buk7456/Arduino-LoRa-RC-transmitter-and-reciever/etc/schematics/Transmitter_ks0108_version.pdf

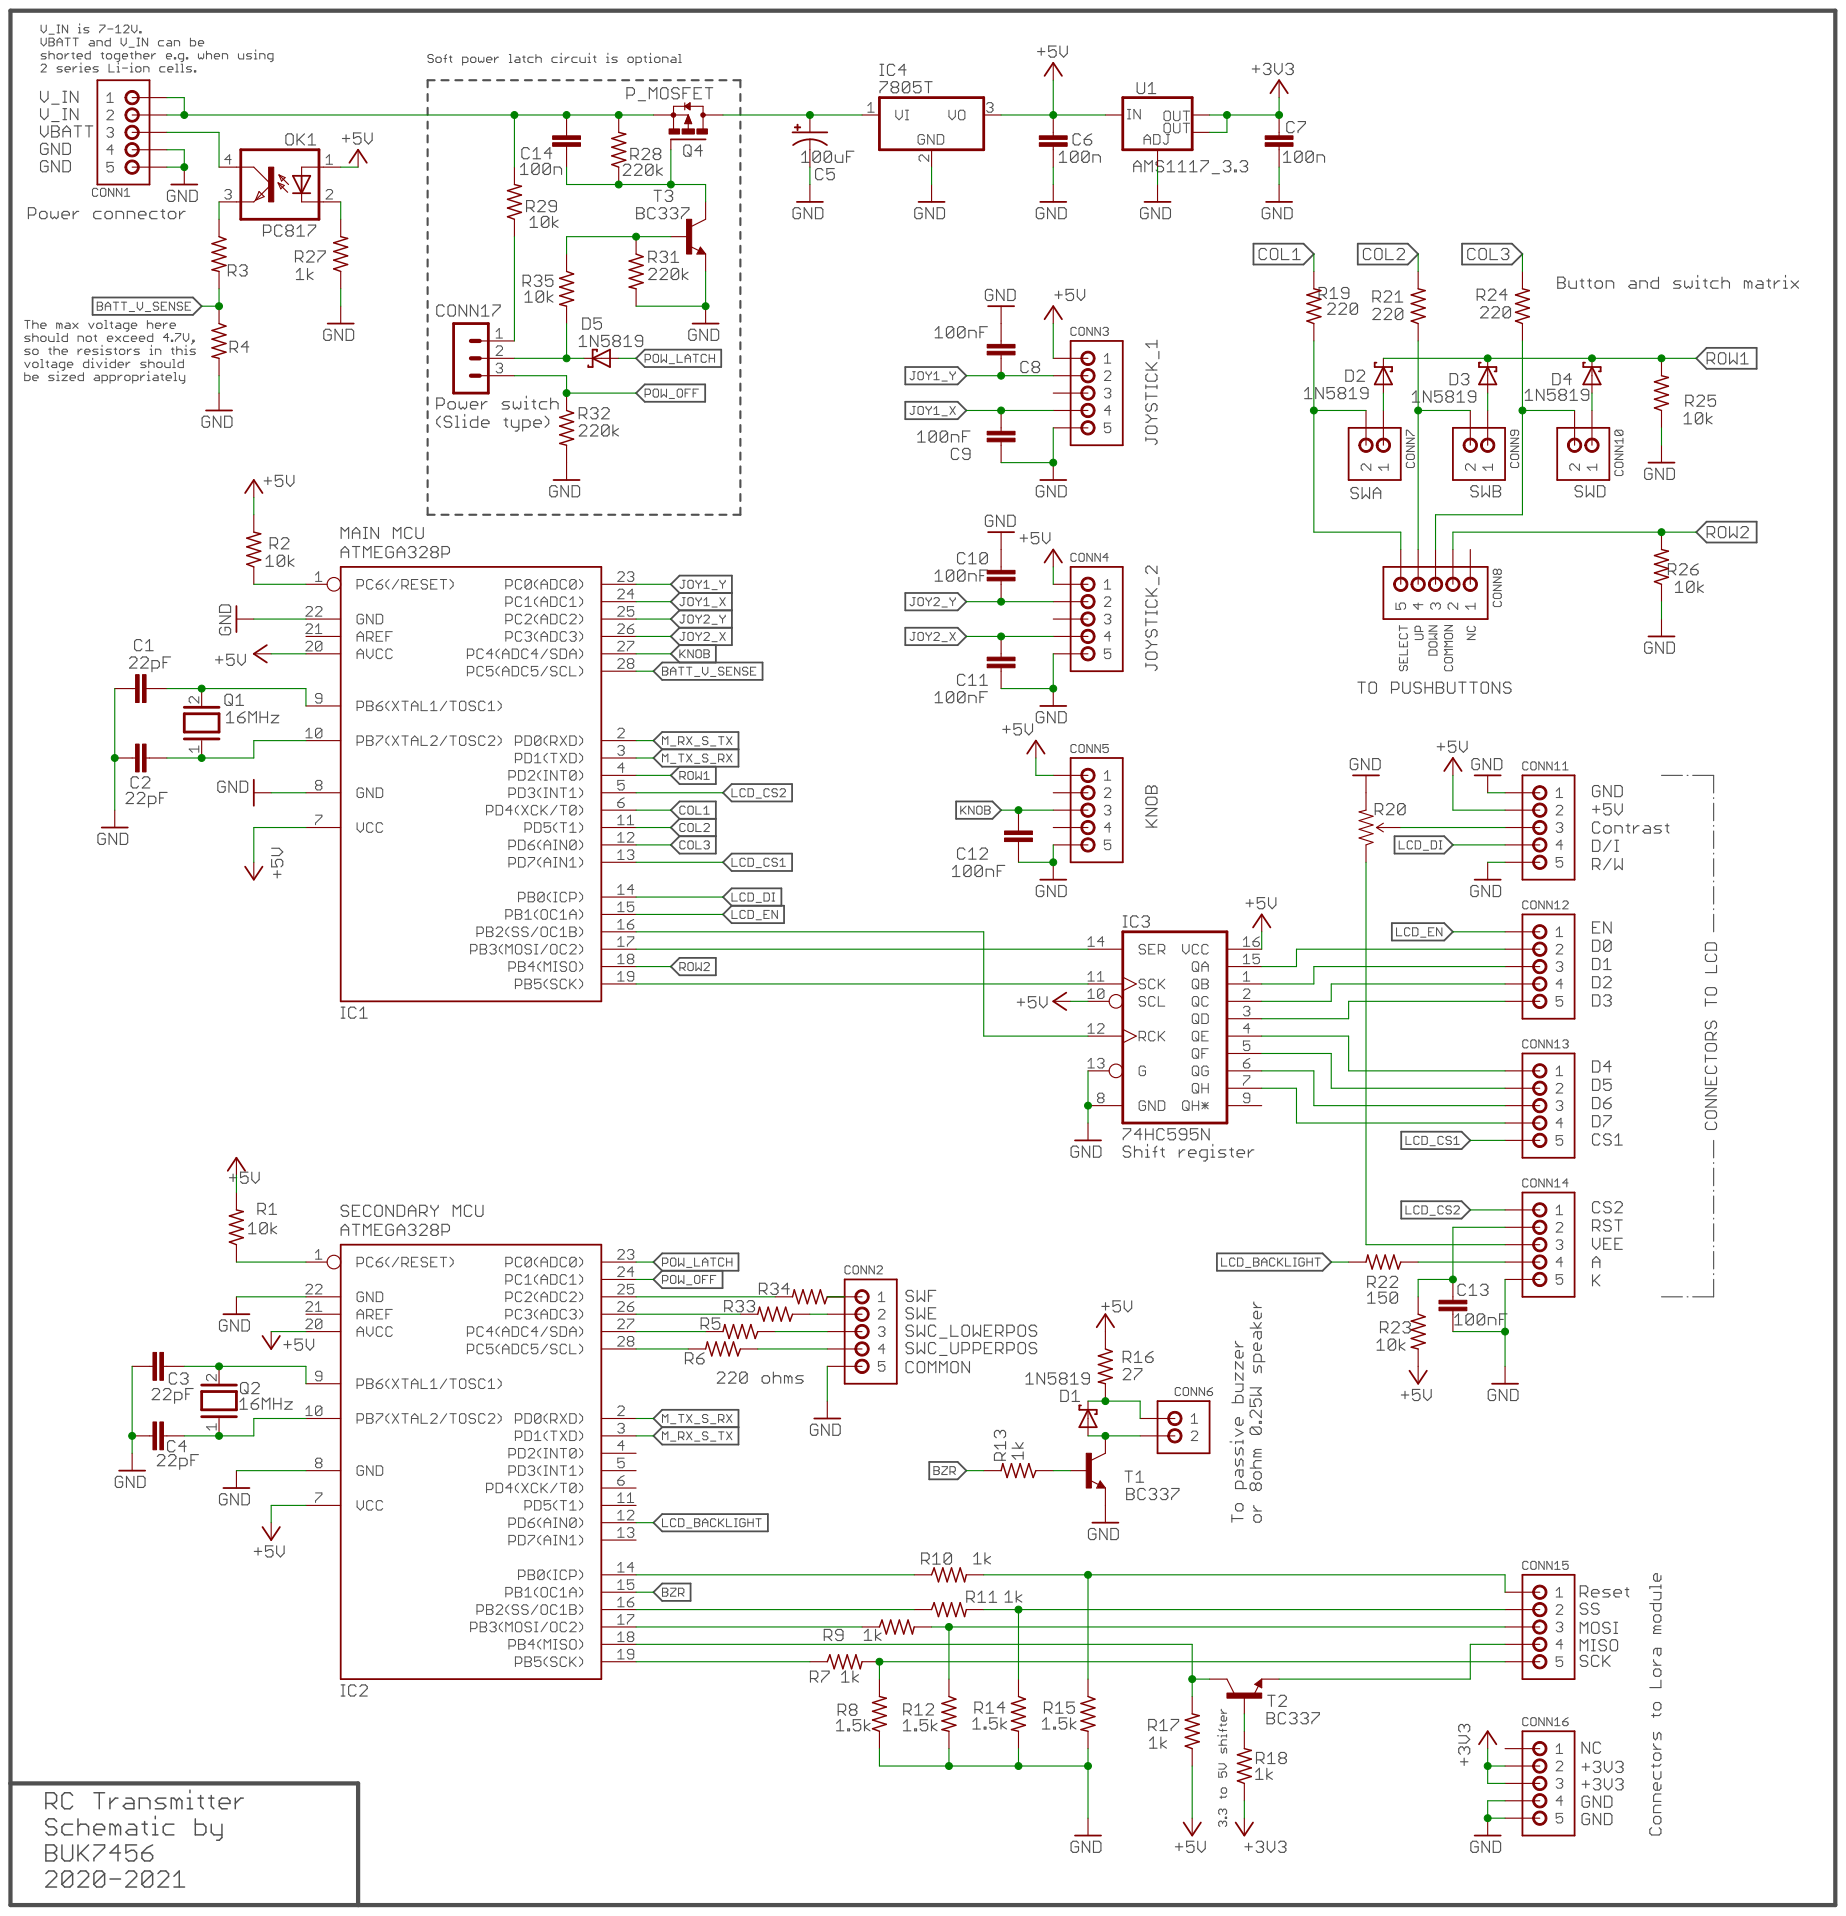
[picture p3: page 1]
