buk7456/Arduino-LoRa-RC-transmitter-and-reciever/etc/schematics/receiver.pdf

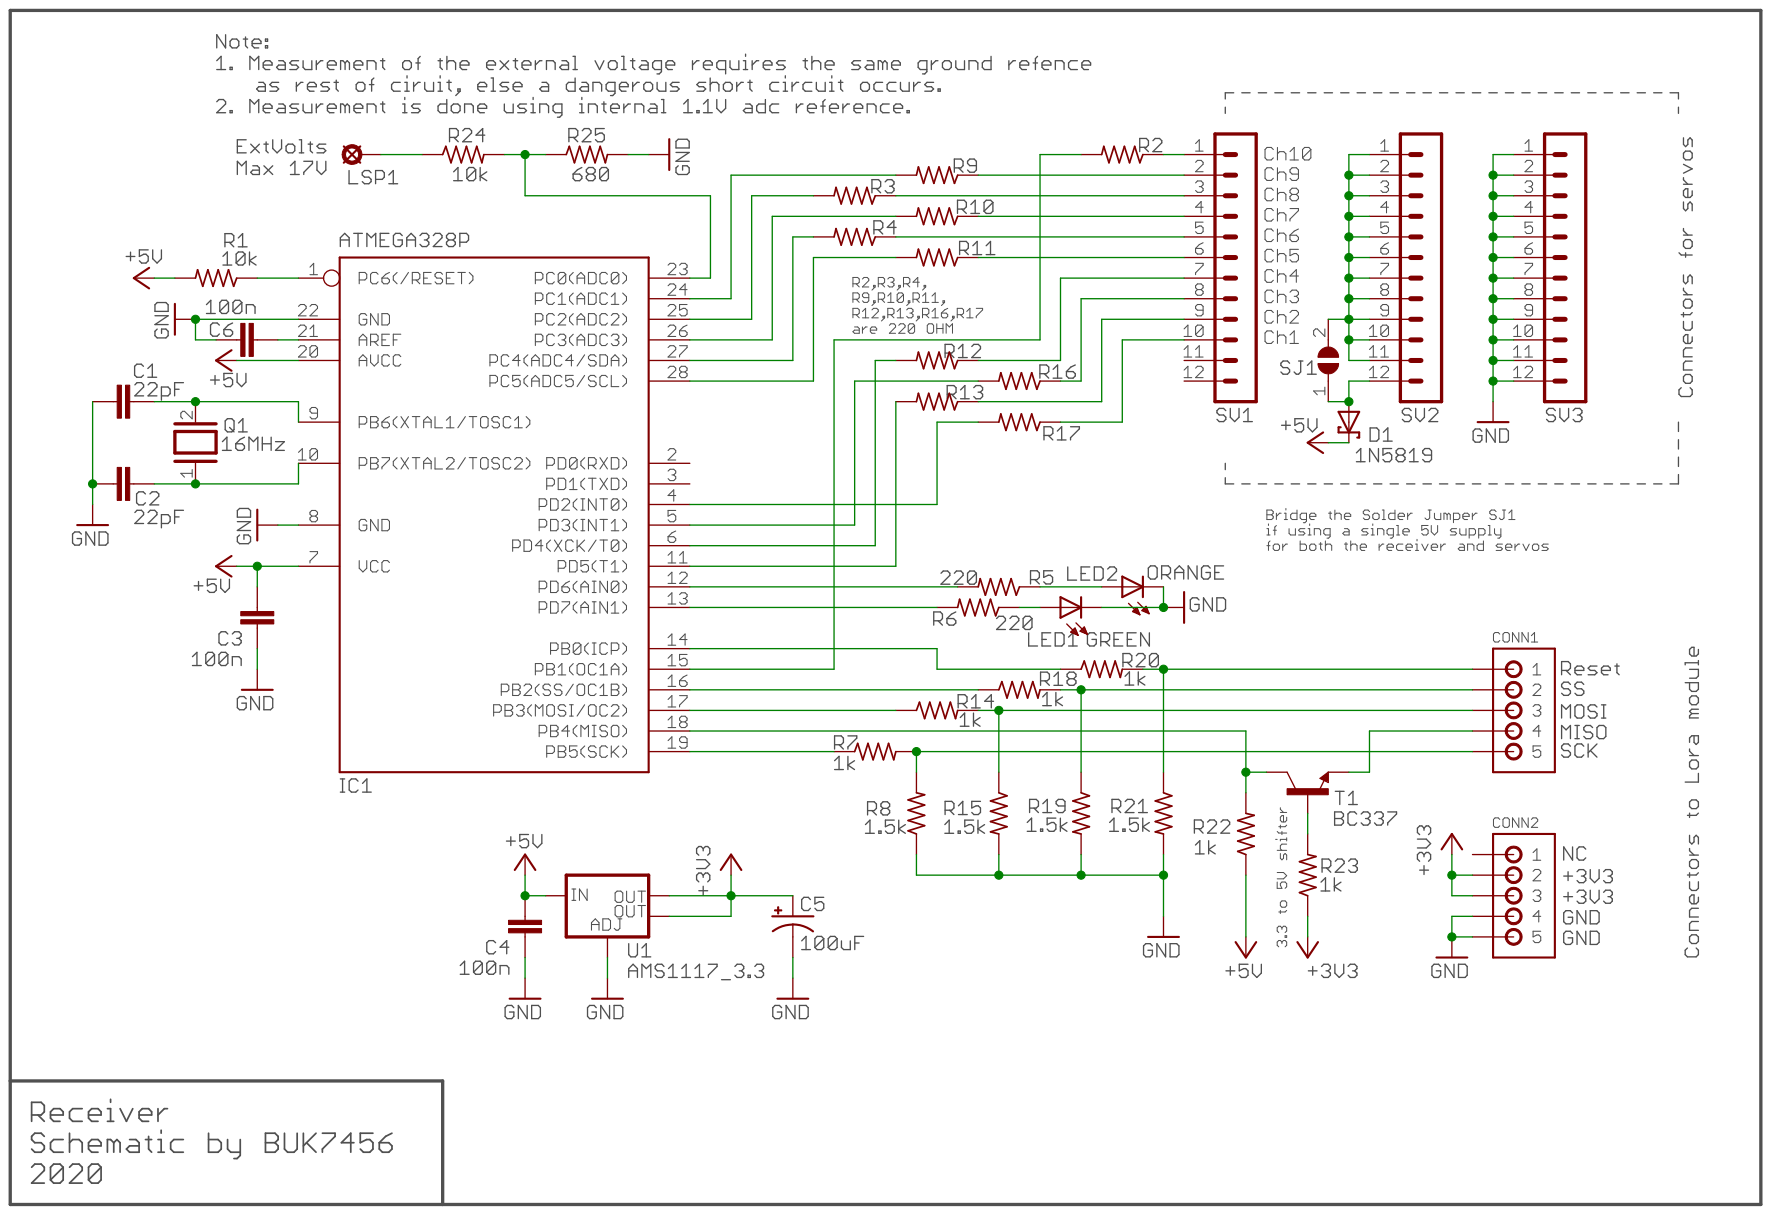
[picture p4: page 1]
