buk7456/Arduino-LoRa-RC-transmitter-and-reciever/(list of files, drawings)

Other design files:
etc/simu/UI128x64simu.pdsprj
