buk7456/Arduino-LoRa-RC-transmitter-and-reciever/etc/schematics/Transmitter_ks0108_version.sch

## EAGLE design etc/schematics/Transmitter_ks0108_version.sch (2021-07-11)

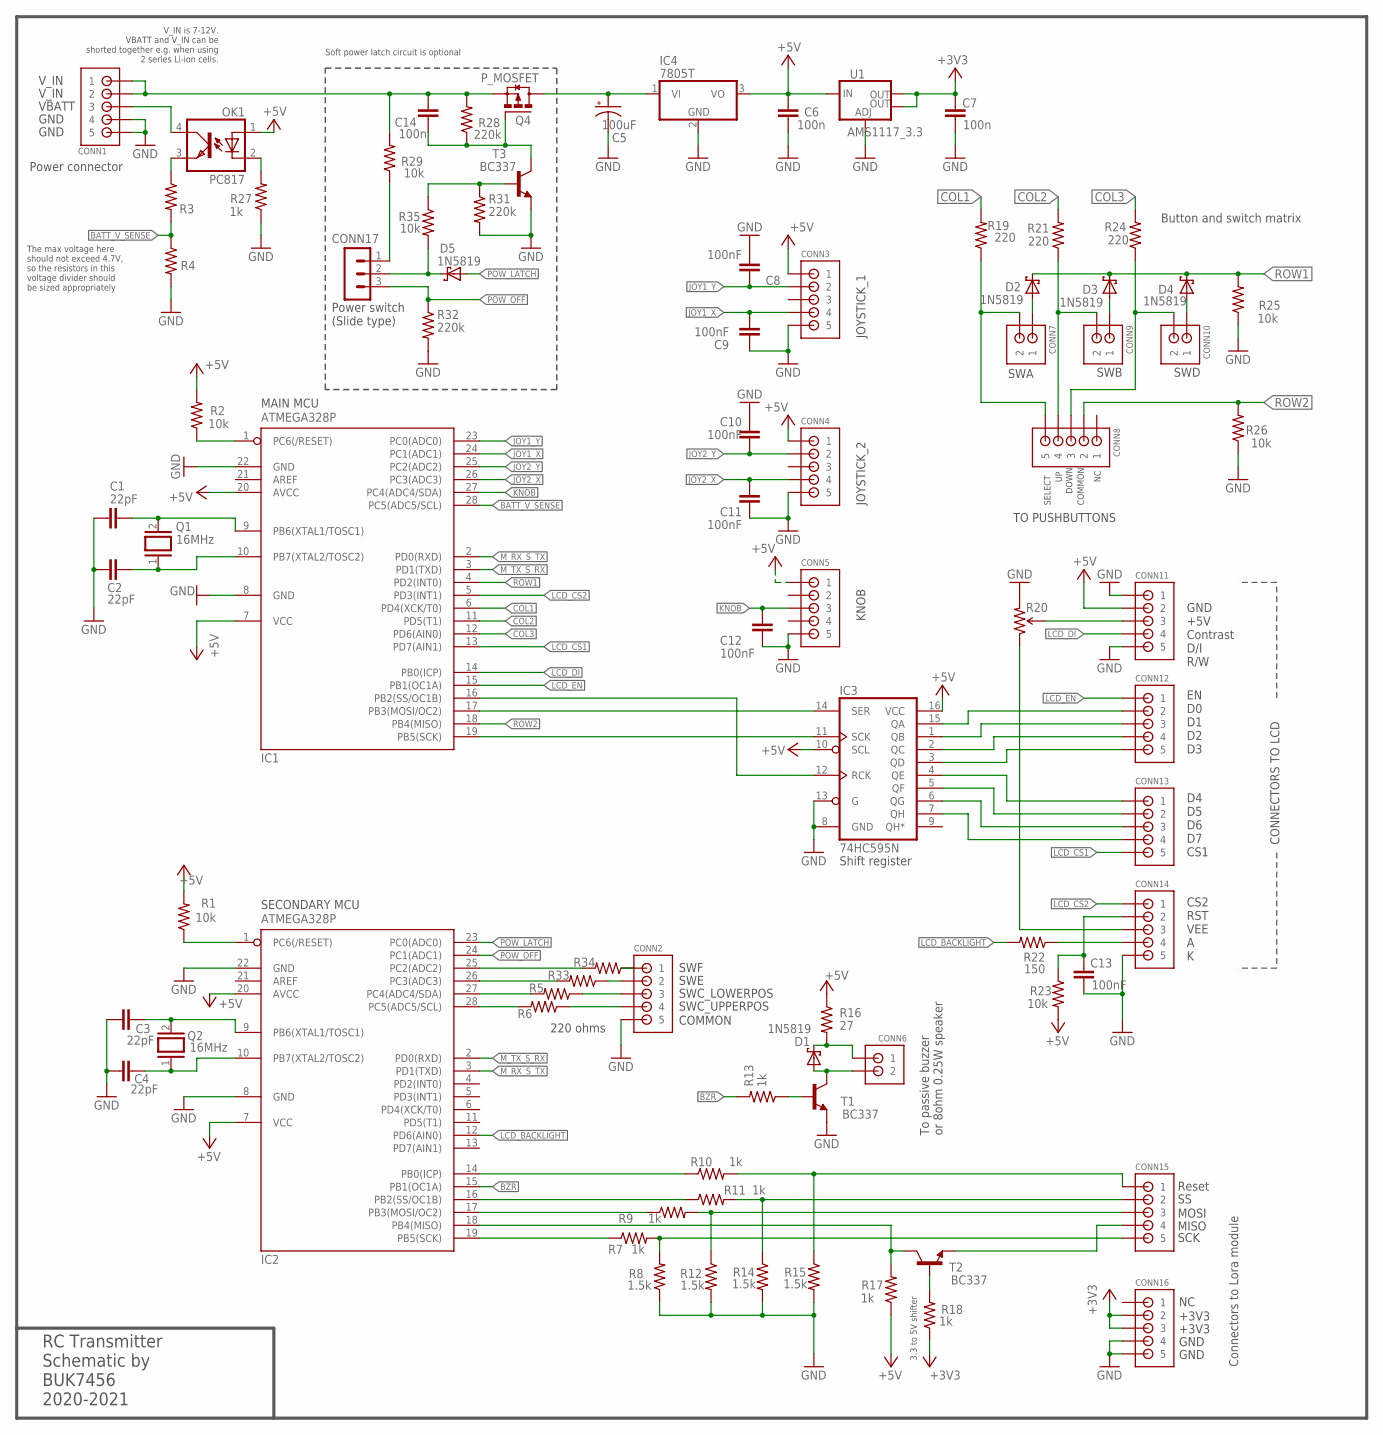
[picture p5: schematic Transmitter_ks0108_version.sch]

Parts:
C1, C2, C3, C4: 22pF; C025-025X050
C5: 100uF; E2,5-6E
C6, C7, C14: 100n; C025-025X050
C8, C9, C10, C11, C12, C13: 100nF; C025-025X050
CONN1: POW; JST_B5B-PH_HEADER
CONN2: RADIO; JST_B5B-PH_HEADER
CONN3, CONN4, CONN5, CONN8, CONN15, CONN16: JST-PH_5-PIN_HEADER; JST_B5B-PH_HEADER
CONN6, CONN7, CONN9, CONN10: JST-PH_2-PIN_HEADER; JST_B2B-PH_HEADER
CONN11, CONN12, CONN13, CONN14: AUX; JST_B5B-PH_HEADER
CONN17: MA03-1
D1, D2, D3, D4, D5: 1N5819; DO41-7.6
IC1, IC2: ATMEGA328P; DIL28-3
IC3: 74HC595N; DIL16
IC4: 7805T; TO220H
OK1: PC817; DIL04
Q1, Q2: 16MHz; QS
Q4: P_MOSFET; SUPER-SOT3
R1, R23: 10k; 0204/5
R2: 10k; 0207/10
R3: 1k; 0207/10
R4, R27: 1k; 0204V
R5, R6, R19, R24, R33, R34: 220; 0204/7
R7, R9, R10, R11, R13, R18: 1k; 0204/5
R8, R12, R14, R15: 1.5k; 0204V
R16: 27; 0204/7
R17: 1k; 0204/7
R20: TRIMPOTPTH; TRIM_POT_PTH
R21: 220; 0207/10
R22: 150; 0204V
R25, R26: 10k; 0204V
R28, R31, R32: 220k; 0204/7
R29, R35: 10k; 0204/7
T1, T2, T3: BC337; TO92
U1: AMS1117_3.3; SOT223

Connections:
+3V3: C7.2, CONN16.P2 (2), CONN16.P3 (3), R18.1, U1.2 (OUT), U1.4 (OUT)
+5V: C6.2, CONN3.P1 (1), CONN4.P1 (1), CONN5.P1 (1), CONN11.P2 (2), IC1.7 (VCC), IC1.20 (AVCC), IC2.7 (VCC), IC2.20 (AVCC), IC3.10 (SCL), IC3.16 (VCC), IC4.3 (VO), OK1.1 (A), R1.2, R2.2, R16.1, R17.1, R23.2, U1.3 (IN)
BATT_V_SENSE: IC1.28 (PC5(ADC5/SCL)), R3.2, R4.1
BZR: IC2.15 (PB1(OC1A)), R13.2
COL1: IC1.6 (PD4(XCK/T0)), R19.2
COL2: IC1.11 (PD5(T1)), R21.2
COL3: IC1.12 (PD6(AIN0)), R24.2
GND: C1.1, C2.1, C3.1, C4.1, C5.-, C6.1, C7.1, C8.2, C9.1, C10.2, C11.1, C12.1, C13.2, CONN1.P4 (4), CONN1.P5 (5), CONN2.P5 (5), CONN3.P5 (5), CONN4.P5 (5), CONN5.P5 (5), CONN11.P1 (1), CONN11.P5 (5), CONN14.P5 (5), CONN16.P4 (4), CONN16.P5 (5), IC1.8 (GND), IC1.22 (GND), IC2.8 (GND), IC2.22 (GND), IC3.8 (GND), IC3.13 (G), IC4.2 (GND), R4.2, R8.1, R12.2, R14.2, R15.2, R20.3 (CW), R25.1, R26.1, R27.1, R31.2, R32.2, T1.1 (E), T3.1 (E), U1.1 (ADJ)
JOY1_X: C9.2, CONN3.P4 (4), IC1.24 (PC1(ADC1))
JOY1_Y: C8.1, CONN3.P2 (2), IC1.23 (PC0(ADC0))
JOY2_X: C11.2, CONN4.P4 (4), IC1.26 (PC3(ADC3))
JOY2_Y: C10.1, CONN4.P2 (2), IC1.25 (PC2(ADC2))
KNOB: C12.2, CONN5.P3 (3), IC1.27 (PC4(ADC4/SDA))
LCD_BACKLIGHT: IC2.12 (PD6(AIN0)), R22.2
LCD_CS1: CONN13.P5 (5), IC1.13 (PD7(AIN1))
LCD_CS2: CONN14.P1 (1), IC1.5 (PD3(INT1))
LCD_DI: CONN11.P4 (4), IC1.14 (PB0(ICP))
LCD_EN: CONN12.P1 (1), IC1.15 (PB1(OC1A))
LCD_RST1: C13.1, CONN14.P2 (2), R23.1
MASTER_RST: IC1.1 (PC6(/RESET)), R2.1
MASTER_RST1: IC2.1 (PC6(/RESET)), R1.1
MISO: IC2.18 (PB4(MISO)), R17.2, T2.3 (C)
M_RX_S_TX: IC1.2 (PD0(RXD)), IC2.3 (PD1(TXD))
M_TX_S_RX: IC1.3 (PD1(TXD)), IC2.2 (PD0(RXD))
unnamed: CONN1.P3 (3), OK1.4 (COL)
unnamed: CONN12.P2 (2), IC3.15 (QA)
unnamed: CONN12.P3 (3), IC3.1 (QB)
unnamed: CONN12.P4 (4), IC3.2 (QC)
unnamed: CONN12.P5 (5), IC3.3 (QD)
unnamed: CONN13.P1 (1), IC3.4 (QE)
unnamed: CONN13.P2 (2), IC3.5 (QF)
unnamed: CONN13.P3 (3), IC3.6 (QG)
unnamed: C1.2, IC1.9 (PB6(XTAL1/TOSC1)), Q1.2
unnamed: C2.2, IC1.10 (PB7(XTAL2/TOSC2)), Q1.1
unnamed: IC1.19 (PB5(SCK)), IC3.11 (SCK)
unnamed: CONN14.P4 (4), R22.1
unnamed: IC1.17 (PB3(MOSI/OC2)), IC3.14 (SER)
unnamed: IC1.16 (PB2(SS/OC1B)), IC3.12 (RCK)
unnamed: IC2.28 (PC5(ADC5/SCL)), R6.2
unnamed: C3.2, IC2.9 (PB6(XTAL1/TOSC1)), Q2.2
unnamed: C4.2, IC2.10 (PB7(XTAL2/TOSC2)), Q2.1
unnamed: CONN7.P2 (2), CONN8.P5 (5), R19.1
unnamed: CONN8.P4 (4), CONN9.P2 (2), R21.1
unnamed: CONN8.P3 (3), CONN10.P2 (2), R24.1
unnamed: CONN7.P1 (1), D2.A
unnamed: CONN9.P1 (1), D3.A
unnamed: CONN10.P1 (1), D4.A
unnamed: IC2.14 (PB0(ICP)), R10.1
unnamed: CONN13.P4 (4), IC3.7 (QH)
unnamed: IC2.27 (PC4(ADC4/SDA)), R5.2
unnamed: CONN2.P3 (3), R5.1
unnamed: CONN15.P4 (4), T2.1 (E)
unnamed: CONN2.P4 (4), R6.1
unnamed: IC2.16 (PB2(SS/OC1B)), R11.1
unnamed: R13.1, T1.2 (B)
unnamed: CONN6.P2 (2), D1.A, T1.3 (C)
unnamed: CONN6.P1 (1), D1.C, R16.2
unnamed: CONN15.P2 (2), R11.2, R14.1
unnamed: IC2.17 (PB3(MOSI/OC2)), R9.1
unnamed: R18.2, T2.2 (B)
unnamed: CONN15.P1 (1), R10.2, R15.1
unnamed: OK1.3 (EMIT), R3.1
unnamed: C14.2, CONN1.P1 (1), CONN1.P2 (2), Q4.2 (S), R28.2, R29.2
unnamed: CONN15.P3 (3), R9.2, R12.1
unnamed: IC2.19 (PB5(SCK)), R7.1
unnamed: CONN15.P5 (5), R7.2, R8.2
unnamed: C14.1, Q4.1 (G), R28.1, T3.3 (C)
unnamed: OK1.2 (C), R27.2
unnamed: CONN17.1, R29.1
unnamed: CONN11.P3 (3), R20.2 (WIPER)
unnamed: C5.+, IC4.1 (VI), Q4.3 (D)
unnamed: CONN14.P3 (3), R20.1 (CCW)
unnamed: CONN2.P2 (2), R33.1
unnamed: CONN2.P1 (1), R34.1
unnamed: IC2.26 (PC3(ADC3)), R33.2
unnamed: IC2.25 (PC2(ADC2)), R34.2
unnamed: R31.1, R35.1, T3.2 (B)
unnamed: CONN17.2, D5.C, R35.2
POW_LATCH: D5.A, IC2.23 (PC0(ADC0))
POW_OFF: CONN17.3, IC2.24 (PC1(ADC1)), R32.1
ROW1: D2.C, D3.C, D4.C, IC1.4 (PD2(INT0)), R25.2
ROW2: CONN8.P2 (2), IC1.18 (PB4(MISO)), R26.2

Notes on the sheet:
3.3 to 5V shifter
SELECT
DOWN
COMMON
GND +5V Contrast D/I R/W
EN D0 D1 D2 D3
D4 D5 D6 D7 CS1
CS2 RST VEE A K
Shift register
MAIN MCU
SECONDARY MCU
CONNECTORS TO LCD
GND
VBATT
Power connector
The max voltage here should not exceed 4.7V, so the resistors in this voltage divider should be sized appropriately
JOYSTICK_1
JOYSTICK_2
KNOB
SWA
SWB
SWD
TO PUSHBUTTONS
To passive buzzer or 8ohm 0.25W speaker
Button and switch matrix
Connectors to Lora module
Reset
MOSI
MISO
SCK
+3V3
RC Transmitter Schematic by BUK7456 2020-2021
Power switch (Slide type)
220 ohms
SWE
SWF
SWC_LOWERPOS
SWC_UPPERPOS
Soft power latch circuit is optional
V_IN
V_IN is 7-12V. VBATT and V_IN can be shorted together e.g. when using 2 series Li-ion cells.
