buk7456/Arduino-LoRa-RC-transmitter-and-reciever/etc/schematics/receiver.sch

## EAGLE design etc/schematics/receiver.sch (2021-03-05)

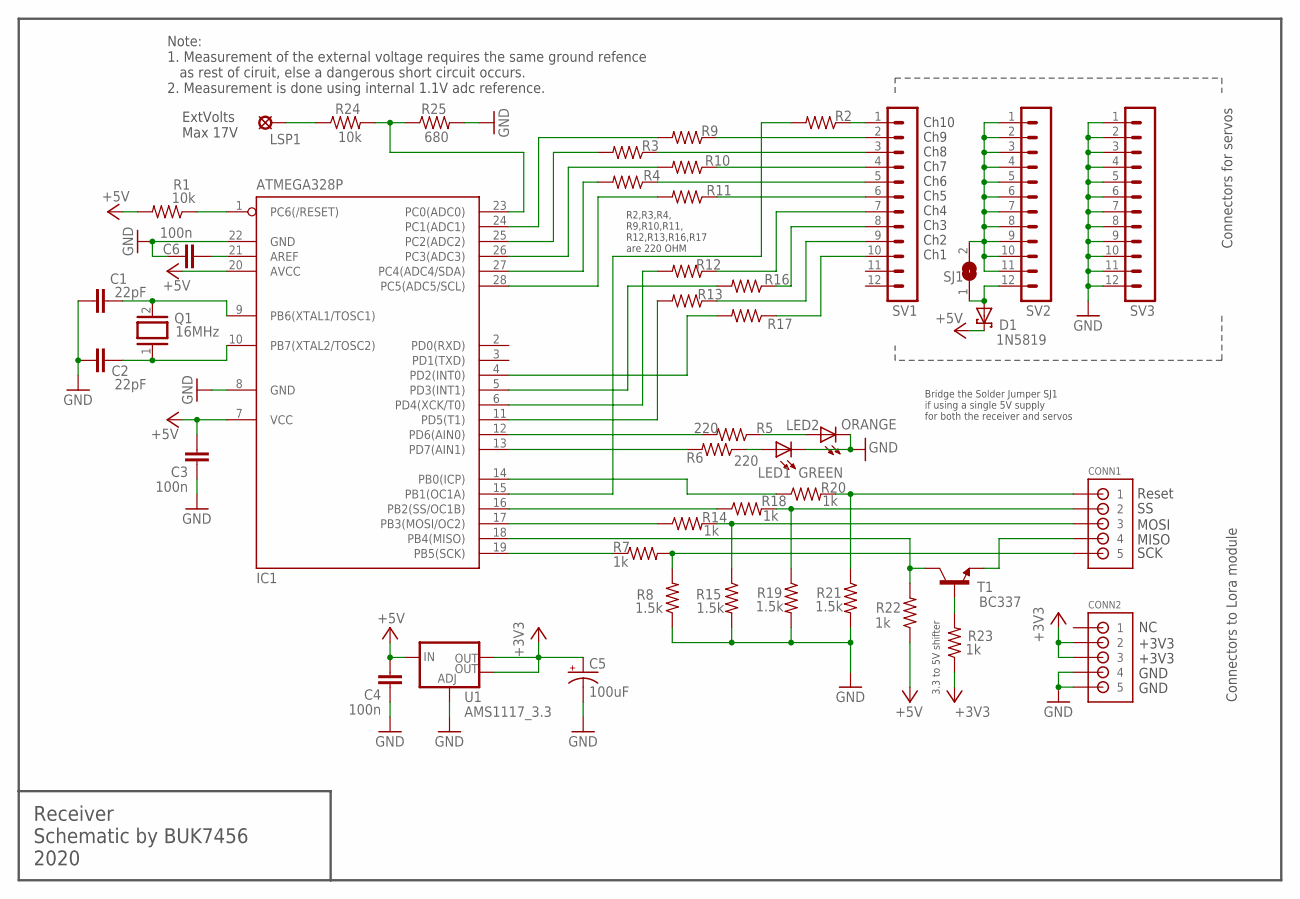
[picture p6: schematic receiver.sch]

Parts:
C1, C2: 22pF; C025-025X050
C3, C4, C6: 100n; C025-025X050
C5: 100uF; E2,5-6E
CONN1, CONN2: JST-PH_5-PIN_HEADER; JST_B5B-PH_HEADER
D1: 1N5819; DO41-7.6
IC1: ATMEGA328P; DIL28-3
LED1: GREEN; LED3MM
LED2: ORANGE; LED3MM
LSP1: LSP10
Q1: 16MHz; QS
R1, R24: 10k; 0204/5
R2, R3, R4, R9, R10, R11, R12, R13, R16, R17: 220; 0204V
R5, R6: 220; 0204/5
R7, R14, R18, R20, R23: 1k; 0204/5
R8, R15, R19, R21: 1.5k; 0204V
R22: 1k; 0204/7
R25: 680; 0204/5
SJ1: SJ
SV1, SV2, SV3: MA12-1
T1: BC337; TO92
U1: AMS1117_3.3; SOT223

Connections:
+3V3: C5.+, CONN2.P2 (2), CONN2.P3 (3), R23.1, U1.2 (OUT), U1.4 (OUT)
+5V: C3.2, C4.2, D1.C, IC1.7 (VCC), IC1.20 (AVCC), R1.2, R22.1, U1.3 (IN)
EXT_V_MAX_17V: LSP1.MP, R24.1
GND: C1.1, C2.1, C3.1, C4.1, C5.-, C6.2, CONN2.P4 (4), CONN2.P5 (5), IC1.8 (GND), IC1.22 (GND), LED1.K (C), LED2.K (C), R8.1, R15.2, R19.2, R21.2, R25.2, SV3.1, SV3.2, SV3.3, SV3.4, SV3.5, SV3.6, SV3.7, SV3.8, SV3.9, SV3.10, SV3.11, SV3.12, U1.1 (ADJ)
MISO: IC1.18 (PB4(MISO)), R22.2, T1.3 (C)
unnamed: IC1.15 (PB1(OC1A)), R2.2
unnamed: IC1.24 (PC1(ADC1)), R9.2
unnamed: IC1.25 (PC2(ADC2)), R3.2
unnamed: IC1.26 (PC3(ADC3)), R10.2
unnamed: IC1.27 (PC4(ADC4/SDA)), R4.2
unnamed: IC1.28 (PC5(ADC5/SCL)), R11.2
unnamed: R2.1, SV1.1
unnamed: R3.1, SV1.3
unnamed: R9.1, SV1.2
unnamed: R10.1, SV1.4
unnamed: R4.1, SV1.5
unnamed: R11.1, SV1.6
unnamed: IC1.4 (PD2(INT0)), R17.2
unnamed: IC1.5 (PD3(INT1)), R16.2
unnamed: R12.1, SV1.7
unnamed: C1.2, IC1.9 (PB6(XTAL1/TOSC1)), Q1.2
unnamed: C2.2, IC1.10 (PB7(XTAL2/TOSC2)), Q1.1
unnamed: R16.1, SV1.8
unnamed: R17.1, SV1.10
unnamed: IC1.6 (PD4(XCK/T0)), R12.2
unnamed: SJ1.2, SV2.1, SV2.2, SV2.3, SV2.4, SV2.5, SV2.6, SV2.7, SV2.8, SV2.9, SV2.10, SV2.11
unnamed: LED2.A, R5.1
unnamed: IC1.11 (PD5(T1)), R13.2
unnamed: IC1.16 (PB2(SS/OC1B)), R18.1
unnamed: R13.1, SV1.9
unnamed: LED1.A, R6.1
unnamed: IC1.12 (PD6(AIN0)), R5.2
unnamed: CONN1.P4 (4), T1.1 (E)
unnamed: IC1.13 (PD7(AIN1)), R6.2
unnamed: C6.1, IC1.21 (AREF)
unnamed: IC1.23 (PC0(ADC0)), R24.2, R25.1
unnamed: D1.A, SJ1.1, SV2.12
unnamed: CONN1.P2 (2), R18.2, R19.1
unnamed: IC1.17 (PB3(MOSI/OC2)), R14.1
unnamed: R23.2, T1.2 (B)
unnamed: IC1.14 (PB0(ICP)), R20.1
unnamed: CONN1.P1 (1), R20.2, R21.1
unnamed: CONN1.P3 (3), R14.2, R15.1
unnamed: IC1.19 (PB5(SCK)), R7.1
unnamed: CONN1.P5 (5), R7.2, R8.2
RST: IC1.1 (PC6(/RESET)), R1.1

Notes on the sheet:
3.3 to 5V shifter
Connectors to Lora module
Reset
MOSI
MISO
SCK
+3V3
GND
Connectors for servos
Ch10 Ch9 Ch8 Ch7 Ch6 Ch5 Ch4 Ch3 Ch2 Ch1
Bridge the Solder Jumper SJ1 if using a single 5V supply for both the receiver and servos
Receiver Schematic by BUK7456 2020
R2,R3,R4, R9,R10,R11, R12,R13,R16,R17 are 220 OHM
Note: 1. Measurement of the external voltage requires the same ground refence as rest of ciruit, else a dangerous short circuit occurs. 2. Measurement is done using internal 1.1V adc reference.
ExtVolts Max 17V
