buk7456/Arduino-LoRa-RC-transmitter-and-reciever/stx/NonBlockingRtttl.cpp

// ---------------------------------------------------------------------------
// Created by Antoine Beauchamp based on the code from the ToneLibrary
//
// See "NonBlockingRtttl.h" for purpose, syntax, version history, links, and more.
// ---------------------------------------------------------------------------

#include "Arduino.h"
#include "NonBlockingRtttl.h"

/*********************************************************
 * RTTTL Library data
 *********************************************************/

namespace rtttl
{

const int notes[] = { 0,
NOTE_C4, NOTE_CS4, NOTE_D4, NOTE_DS4, NOTE_E4, NOTE_F4, NOTE_FS4, NOTE_G4, NOTE_GS4, NOTE_A4, NOTE_AS4, NOTE_B4,
NOTE_C5, NOTE_CS5, NOTE_D5, NOTE_DS5, NOTE_E5, NOTE_F5, NOTE_FS5, NOTE_G5, NOTE_GS5, NOTE_A5, NOTE_AS5, NOTE_B5,
NOTE_C6, NOTE_CS6, NOTE_D6, NOTE_DS6, NOTE_E6, NOTE_F6, NOTE_FS6, NOTE_G6, NOTE_GS6, NOTE_A6, NOTE_AS6, NOTE_B6,
NOTE_C7, NOTE_CS7, NOTE_D7, NOTE_DS7, NOTE_E7, NOTE_F7, NOTE_FS7, NOTE_G7, NOTE_GS7, NOTE_A7, NOTE_AS7, NOTE_B7
};

//#define isdigit(n) (n >= '0' && n <= '9')
#define OCTAVE_OFFSET 0

const char * buffer = "";
int bufferIndex = -32760;
byte default_dur = 4;
byte default_oct = 5;
int bpm = 63;
long wholenote;
byte pin = -1;
unsigned long noteDelay = 0; //m will always be after which means the last note is done playing
bool playing = false;

//pre-declaration
void nextnote();

// tone() and noTone() are not implemented for Arduino core for the ESP32
// See https://github.com/espressif/arduino-esp32/issues/980
// and https://github.com/espressif/arduino-esp32/issues/1720
#if defined(ESP32)
void noTone(){
  ledcWrite(0, 0); // channel, volume
}

void noTone(int pin){
  noTone();
}

void tone(int frq) {
  ledcWriteTone(0, frq); // channel, freq
  ledcWrite(0, 255); // channel, volume
}

void tone(int pin, int frq, int duration){
  tone(frq);
}
#endif

void begin(byte iPin, const char * iSongBuffer)
{
  #ifdef RTTTL_NONBLOCKING_DEBUG
  Serial.print("playing: ");
  Serial.println(iSongBuffer);
  #endif
    
  //init values
  pin = iPin;
  #if defined(ESP32)
  ledcSetup(0, 1000, 10); // resolution always seems to be 10bit, no matter what is given
  ledcAttachPin(pin, 0);
  #endif
  buffer = iSongBuffer;
  bufferIndex = 0;
  default_dur = 4;
  default_oct = 6;
  bpm=63;
  playing = true;
  noteDelay = 0;
  #ifdef RTTTL_NONBLOCKING_DEBUG
  Serial.print("noteDelay=");
  Serial.println(noteDelay);
  #endif
  
  //stop current note
  noTone(pin);

  //read buffer until first note
  int num;

  // format: d=N,o=N,b=NNN:
  // find the start (skip name, etc)

  while(*buffer != ':') buffer++;    // ignore name
  buffer++;                     // skip ':'

  // get default duration
  if(*buffer == 'd')
  {
    buffer++; buffer++;              // skip "d="
    num = 0;
    while(isdigit(*buffer))
    {
      num = (num * 10) + (*buffer++ - '0');
    }
    if(num > 0) default_dur = num;
    buffer++;                   // skip comma
  }

  #ifdef RTTTL_NONBLOCKING_INFO
  Serial.print("ddur: "); Serial.println(default_dur, 10);
  #endif
  
  // get default octave
  if(*buffer == 'o')
  {
    buffer++; buffer++;              // skip "o="
    num = *buffer++ - '0';
    if(num >= 3 && num <=7) default_oct = num;
    buffer++;                   // skip comma
  }

  #ifdef RTTTL_NONBLOCKING_INFO
  Serial.print("doct: "); Serial.println(default_oct, 10);
  #endif
  
  // get BPM
  if(*buffer == 'b')
  {
    buffer++; buffer++;              // skip "b="
    num = 0;
    while(isdigit(*buffer))
    {
      num = (num * 10) + (*buffer++ - '0');
    }
    bpm = num;
    buffer++;                   // skip colon
  }

  #ifdef RTTTL_NONBLOCKING_INFO
  Serial.print("bpm: "); Serial.println(bpm, 10);
  #endif

  // BPM usually expresses the number of quarter notes per minute
  wholenote = (60 * 1000L / bpm) * 4;  // this is the time for whole note (in milliseconds)

  #ifdef RTTTL_NONBLOCKING_INFO
  Serial.print("wn: "); Serial.println(wholenote, 10);
  #endif
}

void nextnote()
{
  long duration;
  byte note;
  byte scale;

  //stop current note
  noTone(pin);

  // first, get note duration, if available
  int num = 0;
  while(isdigit(*buffer))
  {
    num = (num * 10) + (*buffer++ - '0');
  }
  
  if(num) duration = wholenote / num;
  else duration = wholenote / default_dur;  // we will need to check if we are a dotted note after

  // now get the note
  note = 0;

  switch(*buffer)
  {
    case 'c':
      note = 1;
      break;
    case 'd':
      note = 3;
      break;
    case 'e':
      note = 5;
      break;
    case 'f':
      note = 6;
      break;
    case 'g':
      note = 8;
      break;
    case 'a':
      note = 10;
      break;
    case 'b':
      note = 12;
      break;
    case 'p':
    default:
      note = 0;
  }
  buffer++;

  // now, get optional '#' sharp
  if(*buffer == '#')
  {
    note++;
    buffer++;
  }

  // now, get optional '.' dotted note
  if(*buffer == '.')
  {
    duration += duration/2;
    buffer++;
  }

  // now, get scale
  if(isdigit(*buffer))
  {
    scale = *buffer - '0';
    buffer++;
  }
  else
  {
    scale = default_oct;
  }

  scale += OCTAVE_OFFSET;

  if(*buffer == ',')
    buffer++;       // skip comma for next note (or we may be at the end)

  // now play the note

  if(note)
  {
    #ifdef RTTTL_NONBLOCKING_INFO
    Serial.print("Playing: ");
    Serial.print(scale, 10); Serial.print(' ');
    Serial.print(note, 10); Serial.print(" (");
    Serial.print(notes[(scale - 4) * 12 + note], 10);
    Serial.print(") ");
    Serial.println(duration, 10);
    #endif
    
    tone(pin, notes[(scale - 4) * 12 + note], duration);
    
    noteDelay = millis() + (duration+1);
  }
  else
  {
    #ifdef RTTTL_NONBLOCKING_INFO
    Serial.print("Pausing: ");
    Serial.println(duration, 10);
    #endif
    
    noteDelay = millis() + (duration);
  }
}

void play()
{
  //if done playing the song, return
  if (!playing)
  {
    #ifdef RTTTL_NONBLOCKING_DEBUG
    Serial.println("done playing...");
    #endif
    
    return;
  }
  
  //are we still playing a note ?
  unsigned long m = millis();
  if (m < noteDelay)
  {
    #ifdef RTTTL_NONBLOCKING_DEBUG
    Serial.println("still playing a note...");
    #endif
    
    //wait until the note is completed
    return;
  }

  //ready to play the next note
  if (*buffer == '\0')
  {
    //no more notes. Reached the end of the last note

    #ifdef RTTTL_NONBLOCKING_DEBUG
    Serial.println("end of note...");
    #endif
    
    //issue #6: Bug for ESP8266 environment - noTone() not called at end of sound.
    //disable sound at the end of a normal playback.
    stop();

    return; //end of the song
  }
  else
  {
    //more notes to play...

    #ifdef RTTTL_NONBLOCKING_DEBUG
    Serial.println("next note...");
    #endif
    
    nextnote();
  }
}

void stop()
{
  if (playing)
  {
    //increase song buffer until the end
    while (*buffer != '\0')
    {
      buffer++;
    }

    //issue #6: Bug for ESP8266 environment - noTone() not called at end of sound.
    //disable sound if one abort playback using the stop() command.
    noTone(pin);

    playing = false;
  }
}

bool done()
{
  return !playing;
}

bool isPlaying()
{
  return playing;
}

}; //namespace
