buk7456/Arduino-LoRa-RC-transmitter-and-reciever/mtx/bitmaps.h

#ifndef _BITMAPS_H_
#define _BITMAPS_H_

#include <avr/pgmspace.h>

static const unsigned char point[] PROGMEM = {
  // 6x7px
  0x20, 0x30, 0xf8, 0xfc, 0xf8, 0x30, 0x20
};

static const unsigned char rf_icon[] PROGMEM = {
  // 7x7px
  0x44, 0x82, 0xba, 0x92, 0x54, 0x10, 0x10
};

static const unsigned char dualrate_icon[] PROGMEM = {
  // 13x6px
  0xff, 0xf8, 0x9e, 0x98, 0xad, 0xa8, 0xad, 0x98, 0x9b, 0xa8, 0xff, 0xf8
};

static const unsigned char checkbox_checked[] PROGMEM = {
  // 7x7px
  0xfa, 0x86, 0x8c, 0xda, 0xf2, 0xa2, 0xfe
};

static const unsigned char checkbox_unchecked[] PROGMEM = {
  // 7x7px
  0xfe, 0x82, 0x82, 0x82, 0x82, 0x82, 0xfe
};

static const unsigned char lock_icon[] PROGMEM = {
  // 6x7px
  0x30, 0x48, 0x48, 0xfc, 0xfc, 0xfc, 0xfc
};

static const unsigned char mute_icon[] PROGMEM = {
  // 7x7px
  0x20, 0x60, 0xea, 0xe4, 0xea, 0x60, 0x20
};

static const unsigned char menu_icon[] PROGMEM = {
  // 8x7px
	0x00, 0x5e, 0x00, 0x5e, 0x00, 0x5e, 0x00
};

static const unsigned char menu_icon_focused[] PROGMEM = {
  // 8x7px
	0xff, 0xa1, 0xff, 0xa1, 0xff, 0xa1, 0xff
};

static const unsigned char asterisk_small[] PROGMEM = {
	//3x3px
	0xa0, 0x40, 0xa0
};

#endif
