buk7456/Arduino-LoRa-RC-transmitter-and-reciever/mtx/ui_128x64.h

#ifndef _UI_128X64_H_
#define _UI_128X64_H_

void initialiseDisplay();

void showThrottleWarning();
void showAnimation();
void showFormattingMsg();
void showEEWarning();
void showEEFormatConfirmation();

void startStickCalibration();

void handleStartupMenu(); 

void handleMainUI(); 

#endif
