buk7456/Arduino-LoRa-RC-transmitter-and-reciever/(commit log)

2020-09-23 Update io.h
    Corrected small flaw in implementation of trims
    [io.h]
2020-12-28 Update schematics
    [Transmitter_ks0108_version.sch, receiver.sch]
2020-12-28 Updated schematics
2021-01-06 Update rx.ino
    Indicate successful bind by flashing LED
