buk7456/Arduino-LoRa-RC-transmitter-and-reciever/(notices)

Notices in the files:
parts and their libraries:
SparkFun-PowerIC: Licensing: Creative Commons ShareAlike 4.0 International - https://creativecommons.org/licenses/by-sa/4.0
